jancelin/MultiProbeCase/README.md

---
layout: default
title: 404
nav_exclude: true
---

# MultiProbeCase

Documentation de MultiProbeCase
