jancelin/MultiProbeCase/assets/flux_diagram_v0.png

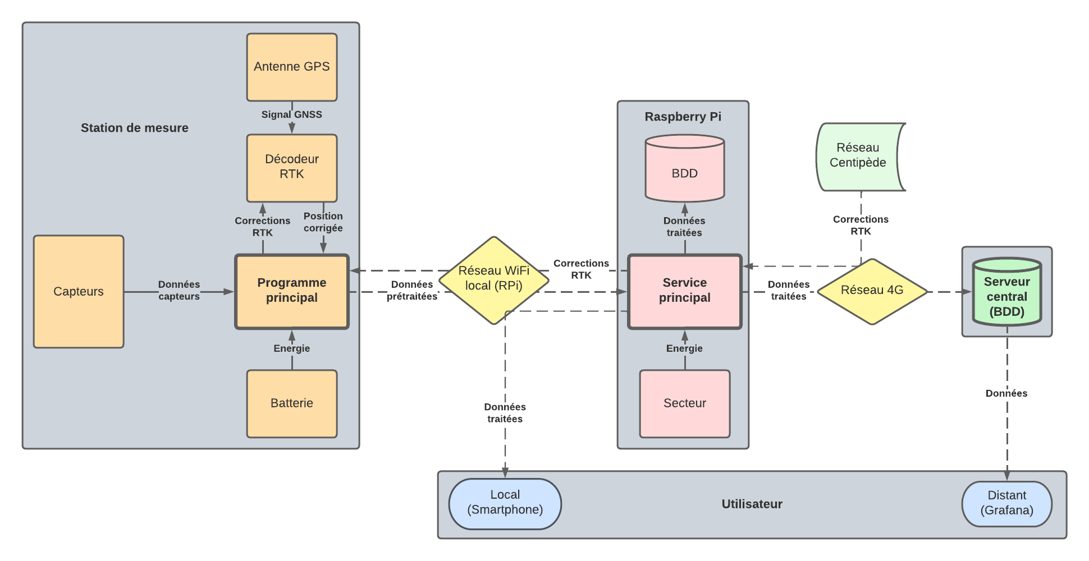
assets/flux_diagram_v0.png
