jancelin/MultiProbeCase/assets/flux_diagram_v1.png

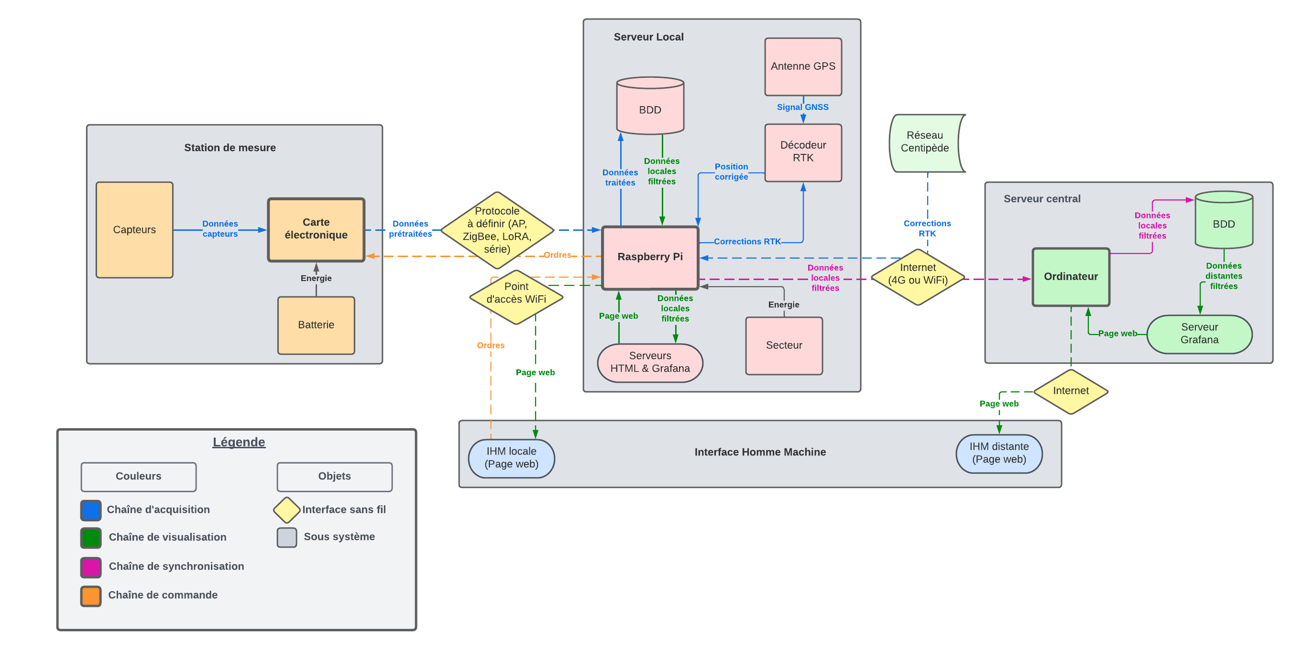
assets/flux_diagram_v1.png
