jancelin/MultiProbeCase/simple_mpc_sat/unit_tests/assets/set_up_img/GNSS_test.jpg

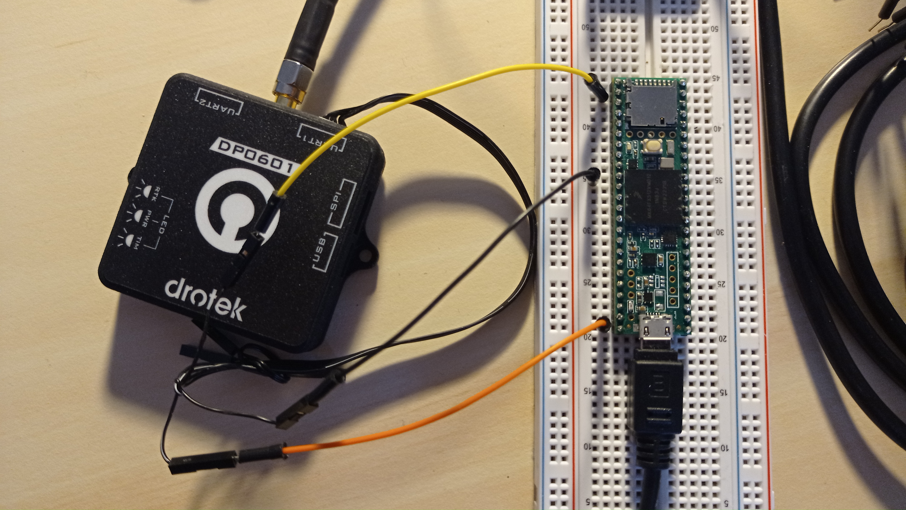
simple_mpc_sat/unit_tests/assets/set_up_img/GNSS_test.jpg
