jancelin/MultiProbeCase/(threads)

Thread 4 (2023-05-23):

Fix LED UI irregular blinks

DeGaMon, 2023-05-23:
# Issue
LED user interface turned out to be misleading because of quick blinks happening right after starting/stopping logging using log button. The longer the system has been logging, the longer those blinks last.

# Steps to reproduce
-  Power the system on.
- Once ```setup()``` is over, enable logging using log button. Few LED flashes occur.
- Leave the system logging for a few minutes.
- Disable logging using log button. LED flashes occur. The longer the system has been logging the longer they last.

# Fix
Reset ```Metro``` timers inside ```handleDigitalIO()``` after updating LED state.

DeGaMon, 2023-05-23:
Fixed in bf1d36bd4327107af64603bd7f358136c57cb325

Closed 2023-05-23.

Thread 5 (2023-06-03):

Clock_logger timestamp conversion issue

DeGaMon, 2023-06-03:
# Description
The clock_logger program had issues to properly convert system timestamp to HH.MM.SS.CC time when generating CSV log strings (```timestampToStr()``` function).
When converted seconds reached the value initially set in ```SECONDS```, the hours were miss converted to the desired hour minus one, until a new minute starts.
## Example:
Here the initial time was set to 23:59:45, meaning that ```SECONDS``` was initialized with the value 45s. When seconds of converted time reached 45, the hour was converted to 23h in stead of 0h.

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

## Steps to reproduce
- In the ```GLOBAL DEFINITIONS``` section, set time to 23:59:45.
- To visualize the converted time in the log file, set ```SERIAL_DBG``` to 0 and ```FILE_DUMP``` to 1 to dump the log file content on to ```Serial``` port.
- Insert an SD card in your Teensy 3.5 and run the program.
- Open a serial monitor and enable logging by pushing the log button.

## Conversion function source code :
```
void timestampToStr(const long& timestamp , String& str, bool add_ms) {

  long t = timestamp;
  uint8_t h,m,s;
  uint16_t ms;

  // Converting timestamp to HH:MM:SS
  h = HOURS + t / (3600 * 1000);
  t %= 3600 * 1000;
  m = MINUTES + t / (60 * 1000);
  t %= 60 * 1000;
  s = SECONDS + t / 1000;
  ms = timestamp%1000;

  // Handling overflows
  if (s >= 60) {
    m++;
    if (m >= 60)
      h++;
  }
  h %= 24;
  m %= 60;
  s %= 60;

  // Writing converted time into a string
  str = String(h) + ':' + String(m) + ':' + String(s);

  // Adding milliseconds
  if (add_ms) {
    str += '.';
    if (ms < 10)
      str += "00";
    else if (ms < 100)
      str += '0';
    str += String(ms);
  }
}

```

# Tasks
- [x] Fix the bug.
- [x] Explain the cause and fix here.

DeGaMon, 2023-06-08:
#Fix
## Cause
This issue was caused by the minute overflow ```if``` clause being inside the seconds overflow ```if``` clause.
This means that if converted seconds did not exceed 60, minute overflow was not checked.
The formula used to convert to seconds is :
```s = SECONDS + t / 1000;```

Closed 2023-06-09.

Thread 7 (2023-09-19):

str2str don't send correction after Bluettoth deconnection/reconnexion #rfcomm

jancelin, 2023-09-19:
## context:

To explain this bug I am going to use an RTK rover containing an F9p ublox with a Bluetooth connection thanks to the HC-05 module connected to the uart1.
On the other side a pc or raspberry pi under linux with rtklib (RTKLIB-b34g) using str2str to redirect data from a CentipedeRTK network base to rfcomm (/dev/rfcomm0) to broadcast the correction to the F9p.

## bug:
str2str no longer sends data if the Bluetooth module disconnects and reconnects, it is necessary to restart str2str to have a data transfer again, yet the logs still show a data transfer.

## method for manufacturing the bug:

### Configure GNSS F9p And BT
https://docs.centipede.fr/docs/make_rover/configuration

### Configure PC/ raspberry pi

* Connect BT:

```bluetoothctl```

  * ```scan on```
 > get mac ex: ```[NEW] Device 00:19:09:01:0B:CF CENTIPEDE```

  * ```pair 00:19:09:01:0B:CF```
> ```[bluetooth]# pair 00:19:09:01:0B:CF```

  * ```trust  00:19:09:01:0B:CF```
>```Changing 00:19:09:01:0B:CF trust succeeded```

  * ```quit```

* Start rfcomm to automatically connect the bluetooth module to the ```/dev/rfcomm0``` port

```sudo rfcomm bind 0 00:19:09:01:0B:CF```

* check that the port is correctly mounted:

``` ls -l /dev```

```
crw-rw----   1 root     dialout 216,     0 sept. 19 13:34 rfcomm0
```
> if you want to stop the service run the command :```sudo rfcomm release 0```

*  start an rtcm3 correction transimition between caster.centipede.fr and the BT module to reach the F9P:

```str2str -in ntrip://:@caster.centipede.fr:80/LIENSS -out serial://rfcomm0:115200:8:N:1:off```
> you can change LIENSS to the base closest to you and in operation ( https://centipede.fr)

**Now the data is sent to the F9P and the RTK LED should glow or flash (check that you are connected to an aerial and that you are in a place where the aerial can see the satellites).**

## Making the bug:

* restart your rover or just the bluetooth module.
**Tthe rtk led (fix/float) no longer glows.Yet you still have correct logs on str2str**

```
2023/09/19 11:46:34 [CE---]     510683 B   11362 bps (0) caster.centipede.fr/LIENSS (1) /dev/rfcomm0
2023/09/19 11:46:39 [CE---]     519530 B   12874 bps (0) caster.centipede.fr/LIENSS (1) /dev/rfcomm0
2023/09/19 11:46:44 [CE---]     525165 B   10957 bps (0) caster.centipede.fr/LIENSS (1) /dev/rfcomm0
2023/09/19 11:46:49 [CE---]     534195 B   14169 bps (0) caster.centipede.fr/LIENSS (1) /dev/rfcomm0
2023/09/19 11:46:54 [CE---]     539785 B   10929 bps (0) caster.centipede.fr/LIENSS (1) /dev/rfcomm0
2023/09/19 11:46:59 [CE---]     548177 B   13405 bps (0) caster.centipede.fr/LIENSS (1) /dev/rfcomm0
2023/09/19 11:47:04 [CE---]     555948 B   14542 bps (0) caster.centipede.fr/LIENSS (1) /dev/rfcomm0
2023/09/19 11:47:09 [CE---]     563424 B   12848 bps (0) caster.centipede.fr/LIENSS (1) /dev/rfcomm0
2023/09/19 11:47:14 [CE---]     571801 B   10935 bps (0) caster.centipede.fr/LIENSS (1) /dev/rfcomm0
```
* Stop str2str (``ctrl c``)
* and restart it (top arrow or the command: ```str2str -in ntrip://:@caster.centipede.fr:80/LIENSS -out serial://rfcomm0:115200:8:N:1:off```)

**The LED on the f9p is glowing again, so the RTCM3 corrections are reaching the f9p....**
