jancelin/MultiProbeCase/(commit log)

2023-03-21 Add cyclopee_sat folder and ESP32_test_distancemetre.ino within
2023-03-21 Update ESP32_test_distancemetre.ino comments
2023-03-21 Add Arduino libraries for cyclopee_sat
2023-03-29 Update temperature_test README
2023-04-12 Add Teensy SD library
2023-05-04 Fixed location and elevation decimals issue and changed String.concat to +=
    [GNSS_logger.ino]
2023-05-04 Changed DP0601 to GNSS_MODULE in enum Device
2023-05-05 Changed gnssRefresh ISR to simple gps object feed and device connection update
2023-05-09 Changed handleDigitalIO() (previously called inside loop()) to interrupt
2023-05-09 Fixed unwanted and irregular LED blinks issue by resetting Metro timers after calling check(). Removed unnecessary Metro timer resets inside handleLogFile().
    [GNSS_logger.ino]
2023-05-10 Added GNSS PDOP and fix mode to logged data
    [GNSS_logger.ino]
2023-05-11 Handled invalid data (disconnected sensor, etc.) in JSON String
2023-05-25 add conf file: firmware & gnss config 5hz
2023-06-08 Replaced .concat by += String operator
    [clock_logger.ino]
2023-06-08 Fixed clock_logger timestamp conversion issue (#5)
    [clock_logger.ino]
2023-06-09 Fixed timestampToStr() conversion overflow in uint8_t variables
    [clock_logger.ino]
2023-06-13 Updated temperatrue_test.ino and ext_temp_comp_test.ino
2023-06-19 Updated DFRobot Gravity pH sensor unit test
2023-06-19 Created Gravity_turbidity library for sensor reading
2023-06-20 Fixed sendATCommand() errors caused by too short delay for receiving data
    [GNSS_logger.ino]
2023-06-21 Added DS18B20 sensor module
2023-06-21 Updated simple_mpc to use sensor modules
2023-06-21 Added sensor modules into libraries
2023-06-21 Updated clock_logger to use sensor modules
2023-06-21 Updated GNSS_logger to use sensor modules
2023-06-22 Moved sensor modules into sensor_modules folder
2023-06-22 Updated Gravity turbidity sensor module
2023-06-22 Updated Gravity turbidity sensor module & simple_mpc
2023-06-29 Adding CO2 & BME280 sensor
2023-07-06 Adding start / stop log order from NodeR to Teensy
2023-07-06 upd Control interface for TEensy
2023-07-07 upd problem serial waiting solved
    [air_sat.ino]
2023-07-12 2nd Gravity Turbidity calibration
2023-07-13 Upd BT Mac to Upper case
2023-07-17 Added A01NYUB sensor module
2023-07-24 Changed clock_logger and sensor_modules for tests
2023-07-28 Added comments to JSN_SR04T sensor module
2023-07-28 Fixed time convertion bug caused by 2 digits milliseconds from TinyGPSPlus in stead of 3 form clock_logger
    [GNSS_logger.ino]
2023-08-01 Updted files during assembly tests
2023-08-02 Fixed missfomat in time to str convertion
    [GNSS_logger.ino]
2023-08-07 Fixed some forgotten variables type changes
    [GNSS_logger.ino]
2023-08-23 Added RTK corrections reception inside gnssRefresh()
    [GNSS_logger.ino]
2023-08-24 Fixed timestamp to time conversion inssue
    [clock_logger.ino]
